Hansern0604/3-phase-inverter/TPIC/TPIC.kicad_pcb

## KiCad design TPIC/TPIC.kicad_pcb (2025-02-25)

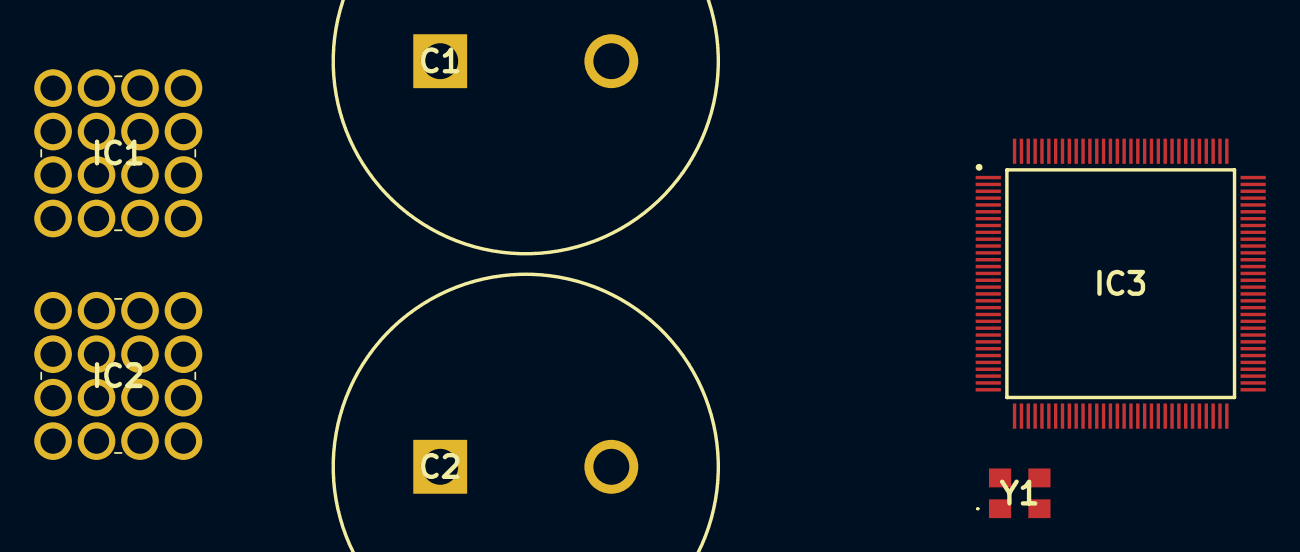
[picture p1: board TPIC.kicad_pcb from above]

Board: 2 copper layers, 6 parts (0 on the bottom side), 2 nets, no tracks yet.

Parts:
C1, C2: MAL225952471E3; CAPPRD1000W190D2250H3700
IC1, IC2: 7461383
IC3: STM32G474QET6; QFP40P1600X1600X160-128N
Y1: ECS-80-10-33-CGN-TR3; ECS801033CGNTR3

Connections:
/Connectors/Vin+: C1.1 (+), C2.1 (+), IC1.1, IC1.2, IC1.3, IC1.4, IC1.5, IC1.6, IC1.7, IC1.8, IC1.9, IC1.10, IC1.11, IC1.12, IC1.13, IC1.14, IC1.15, IC1.16
/Connectors/Vin-: C1.2 (-), C2.2 (-), IC2.1, IC2.2, IC2.3, IC2.4, IC2.5, IC2.6, IC2.7, IC2.8, IC2.9, IC2.10, IC2.11, IC2.12, IC2.13, IC2.14, IC2.15, IC2.16
