Hansern0604/3-phase-inverter/(commit log)

2025-02-21 Oppdatering av filer
    [TPIC.kicad_sch]
2025-02-23 First schematic changes
    [Communication.kicad_sch, Connectors.kicad_sch, CurrrentSense.kicad_sch, Microcontroller.kicad_sch, PowerSupplies.kicad_sch, TPIC.kicad_pcb, TPIC.kicad_sch]
2025-02-25 did some work to the schematic reagrding the MCU
    [Microcontroller.kicad_sch, TPIC.kicad_pcb]
